RandomRunt/Underwater-ROV/Underwater ROV Images/Electronics_Overview.jpg

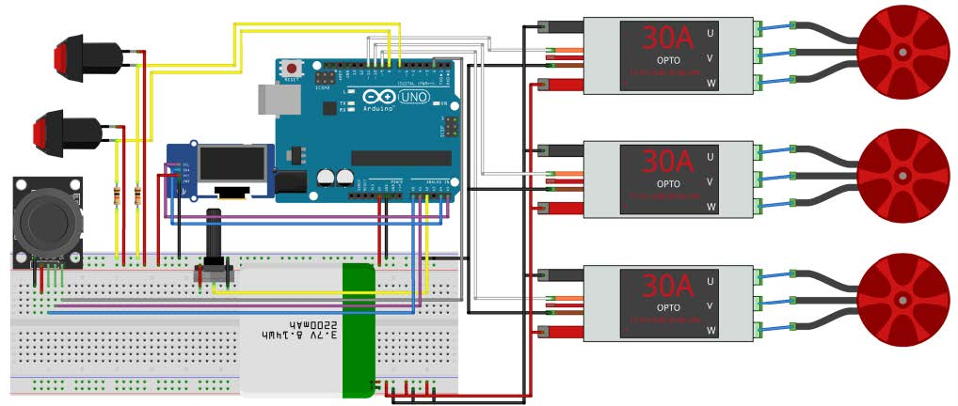
Underwater ROV Images/Electronics_Overview.jpg
