RandomRunt/Underwater-ROV/Underwater ROV Images/Controller_V1.png

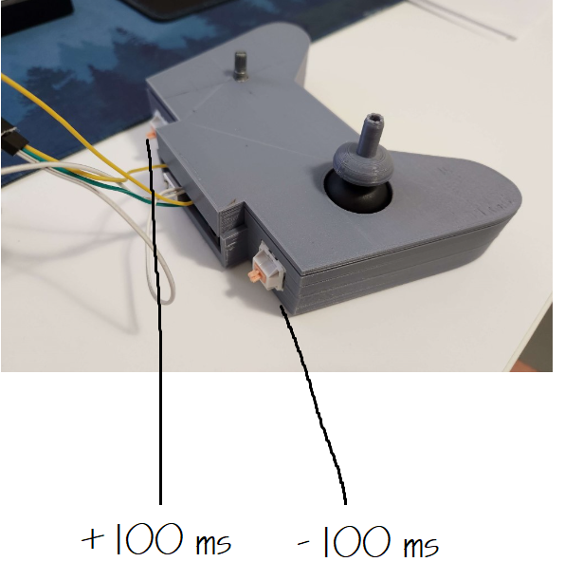
Underwater ROV Images/Controller_V1.png
