RandomRunt/Underwater-ROV/Underwater ROV Images/Controller_V2.png

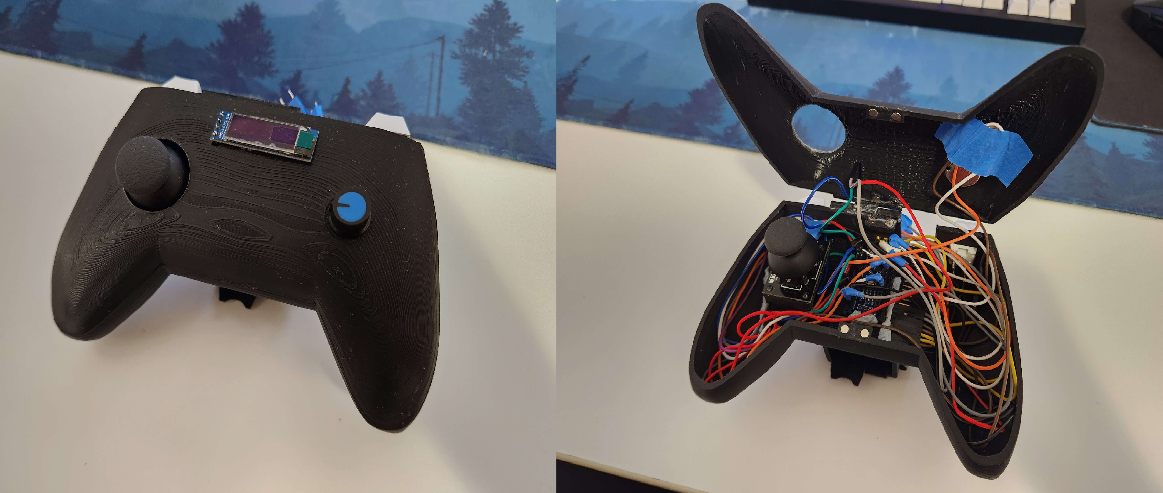
Underwater ROV Images/Controller_V2.png
