RandomRunt/Underwater-ROV/Underwater ROV Images/Controller_V2_CAD.png

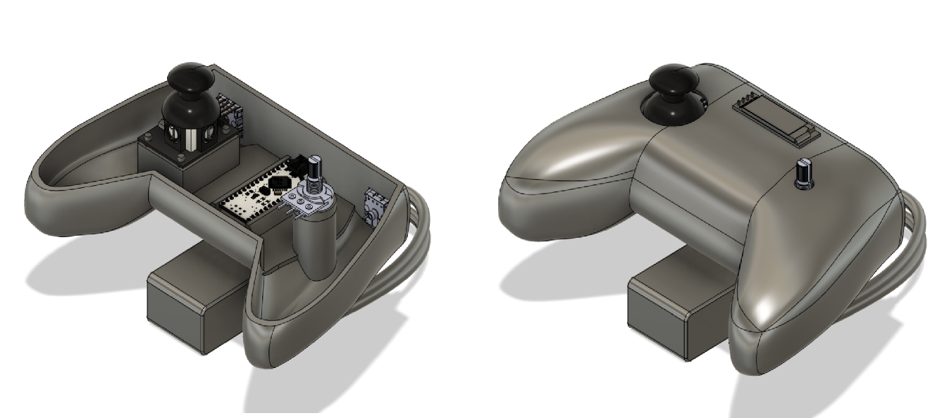
Underwater ROV Images/Controller_V2_CAD.png
