RandomRunt/Underwater-ROV/Underwater ROV Images/ROV_CAD.png

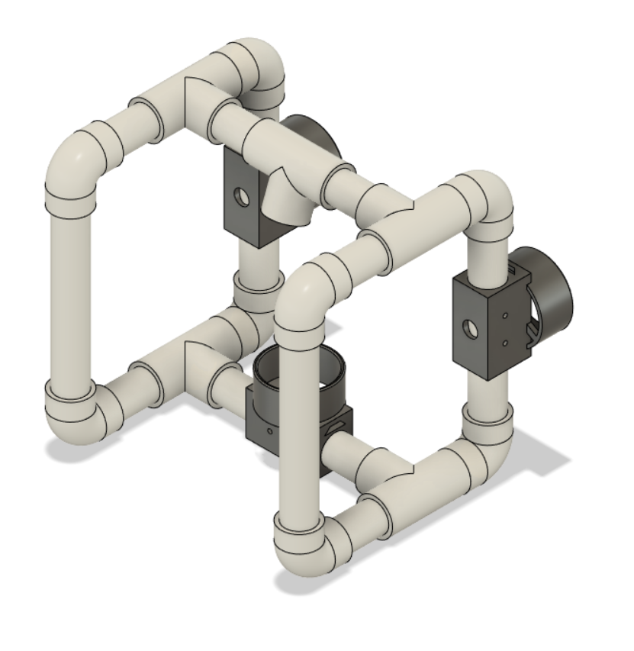
Underwater ROV Images/ROV_CAD.png
