RandomRunt/Underwater-ROV/Underwater ROV Images/ROV_CAD_with_Rings.png

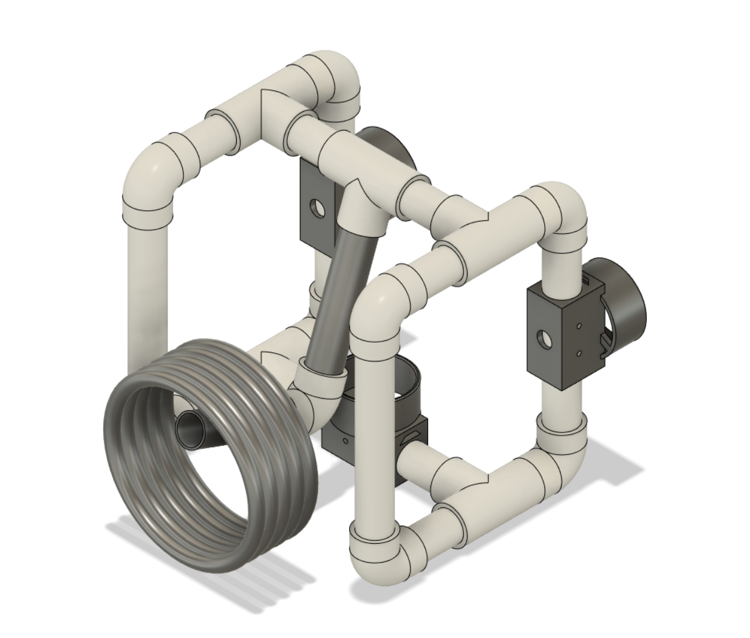
Underwater ROV Images/ROV_CAD_with_Rings.png
