RandomRunt/Underwater-ROV/Underwater ROV Images/Controller Wiring Diagram.png

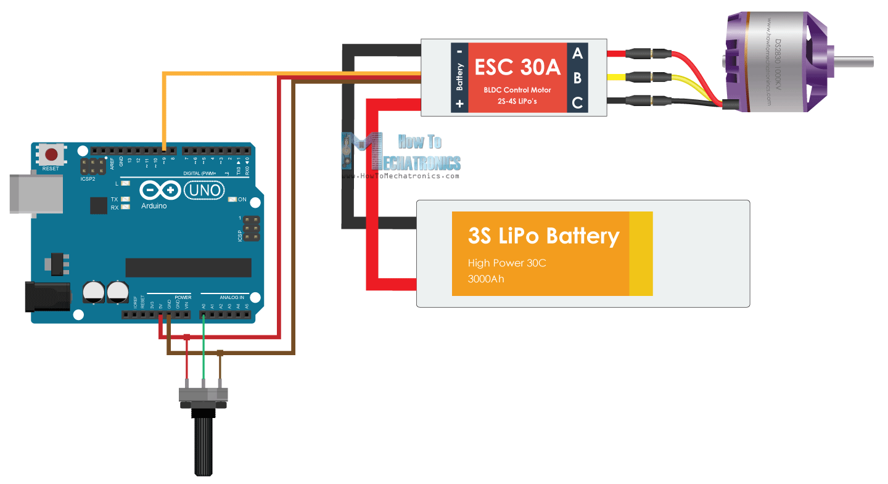
Underwater ROV Images/Controller Wiring Diagram.png
